har-in-air/ESP8266_SPO2_PULSE_LOGGER/docs/sp02_pulse_logger_schematic.pdf

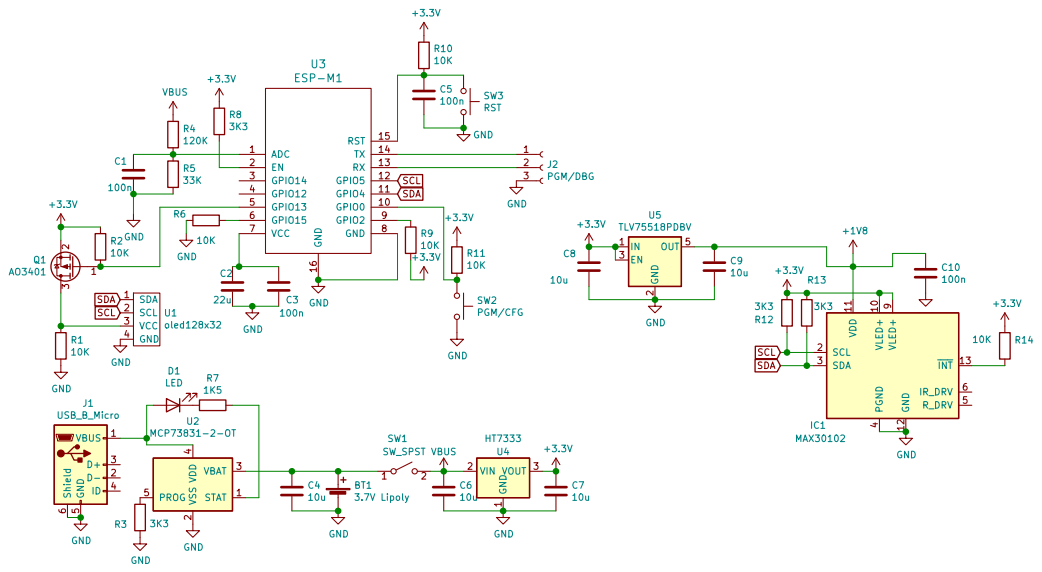
[picture p6: page 1]
