har-in-air/ESP8266_SPO2_PULSE_LOGGER/src/algorithm_by_RF.h

/*
 * Created by Robert Fraczkiewicz, 01/2018
 * New signal processing methodology for obtaining heart rate and SpO2 data 
 * from the MAX30102 sensor manufactured by MAXIM Integrated Products, Inc.
 */
/*******************************************************************************
* Copyright (C) 2017 Robert Fraczkiewicz, All Rights Reserved.
*
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
* The mere transfer of this software does not imply any licenses
* of trade secrets, proprietary technology, copyrights, patents,
* trademarks, maskwork rights, or any other form of intellectual
* property whatsoever. Robert Fraczkiewicz retains all
* ownership rights.
*******************************************************************************
*/
#ifndef ALGORITHM_BY_RF_H_
#define ALGORITHM_BY_RF_H_
#include <Arduino.h>

/*
 * Settable parameters 
 * Leave these alone if your circuit and hardware setup match the defaults 
 * described in this code's Instructable. Typically, different sampling rate
 * and/or sample length would require these paramteres to be adjusted.
 */
 
#define ST  5     // Sampling time in s. WARNING: if you change ST, then you MUST recalcuate the sum_X2 parameter below!
#define FS 25     // Sampling frequency in Hz. WARNING: if you change FS, then you MUST recalcuate the sum_X2 parameter below!
// Sum of squares of ST*FS numbers from -mean_X (see below) to +mean_X incremented be one. For example, given ST=4 and FS=50,
// the sum consists of 200 terms: (-99.5)^2 + (-98.5)^2 + (-97.5)^2 + ... + (97.5)^2 + (98.5)^2 + (99.5)^2
// The sum is symmetrc, so you can evaluate it by multiplying its positive half by 2. It is precalcuated here for enhanced 
// performance.
const float sum_X2 = 162750.0; // WARNING: you MUST recalculate this sum if you changed either ST or FS above!
// WARNING: The two parameters below are CRUCIAL! Proper HR evaluation depends on these.
#define MAX_HR 180  // Maximal heart rate. To eliminate erroneous signals, calculated HR should never be greater than this number.
#define MIN_HR 40   // Minimal heart rate. To eliminate erroneous signals, calculated HR should never be lower than this number.
// Minimal ratio of two autocorrelation sequence elements: one at a considered lag to the one at lag 0.
// Good quality signals must have such ratio greater than this minimum.
const float min_autocorrelation_ratio = 0.5;
// Pearson correlation between red and IR signals.
// Good quality signals must have their correlation coefficient greater than this minimum.
const float min_pearson_correlation = 0.8;

/*
 * Derived parameters 
 * Do not touch these! 
 * 
 */
const int32_t RFA_BUFFER_SIZE = FS*ST; // Number of smaples in a single batch
const int32_t FS60 = FS*60;  // Conversion factor for heart rate from bps to bpm
const int32_t LOWEST_PERIOD = FS60/MAX_HR; // Minimal distance between peaks
const int32_t HIGHEST_PERIOD = FS60/MIN_HR; // Maximal distance between peaks
const float mean_X = (float)(RFA_BUFFER_SIZE-1)/2.0; // Mean value of the set of integers from 0 to RFA_BUFFER_SIZE-1. For ST=4 and FS=50 it's equal to 99.5.

void rf_heart_rate_and_oxygen_saturation(int circ_buffer_index, float *pun_ir_buffer, float *pun_red_buffer, int n_ir_buffer_length,  float *pn_spo2, bool *pspo2_valid, int32_t *pn_heart_rate, 
                                        bool *phr_valid);
float rf_linear_regression_beta(float *pn_x, float xmean, float sum_x2);
float rf_autocorrelation(float *pn_x, int32_t n_size, int32_t n_lag);
float rf_rms(float *pn_x, int32_t n_size, float *sumsq);
float rf_Pcorrelation(float *pn_x, float *pn_y, int32_t n_size);
void rf_initialize_periodicity_search(float *pn_x, int32_t n_size, int32_t *p_last_periodicity, int32_t n_max_distance, float min_aut_ratio, float aut_lag0);
void rf_signal_periodicity(float *pn_x, int32_t n_size, int32_t *p_last_periodicity, int32_t n_min_distance, int32_t n_max_distance, float min_aut_ratio, float aut_lag0, float *ratio);

#endif /* ALGORITHM_BY_RF_H_ */
