har-in-air/ESP8266_SPO2_PULSE_LOGGER/(commit log)

2020-07-13 shutdown sensor on hard fault
2020-07-20 use RGB LEDs as indicators, configure Thingspeak via WifiManager portal and save to Json file
2020-07-21 change led indication, Wifi off/on power management
2020-07-22 add iir filtering, change update interval to seconds
2020-07-25 add schematic
2020-07-26 add battery and wifi icons to display
2021-01-06 add prototype snapshot
2021-07-12 fix timeout, tweak IIR filter
    [main.cpp]
2021-07-12 move sampling to timer callback, cleanup code
2021-07-13 analyze every sample, display every second
2021-08-19 optional kalman filtering of raw signal
2022-12-24 local copy of arduinojson v5.13.5
